ldevillez/customKeyboard/README.md

# customKeyboard

Improve tipping skills
