ldevillez/customKeyboard/custom_V1/readme.md

# V1
The V1 is based on the ergodox but with sone nice features
* USB C
* USB hub (2.0)
* Each half are independent
##

## subversions
* The "logic" version of the pcb is just the upper-part of it with all the logic(teensy, hub,leds) to have a smaller pcb. It would have been great to have it reduce under 10 mm. The all version is also there for the switch.

## Shopping list
<table>
  <thead>
    <tr>
    <th>Amount</th>
    <th>Part type</th>
    <th>Description</th>
    <th>Price (to pay)</th>
    <th>Link</th>
    </tr>
  </thead>
  <tbody>
    <tr>
      <th>2</th>
      <th>Teensy LC</th>
      <th> </th>
      <th>28.44</th>
      <th>https://www.digikey.be/product-detail/fr/sparkfun-electronics/DEV-13305/1568-1233-ND/5721428</th>
    </tr>
    <tr>
      <th>4</th>
      <th>Header 14*1 2.54mm</th>
      <th>For teensy</th>
      <th>2.4</th>
      <th>https://www.digikey.be/product-detail/en/w%C3%BCrth-elektronik/61301411121/732-5325-ND/4846849</th>
    </tr>
    <tr>
      <th>10</th>
      <th>Led jaune SMD</th>
      <th>For usb hub</th>
      <th>2.33</th>
      <th>https://www.digikey.be/product-detail/fr/qt-brightek-qtb/QBLP615-Y/1516-1077-1-ND/4814804</th>
    </tr>
    <tr>
      <th>16</th>
      <th>R smd 150</th>
      <th>R smd led</th>
      <th>3.6</th>
      <th>https://www.digikey.be/product-detail/fr/rohm-semiconductor/LTR18EZPF1500/RHM150YCT-ND/4055449</th>
    </tr>
    <tr>
      <th>8</th>
      <th>R smd 4.99k</th>
      <th>For usb type C </th>
      <th>2.36</th>
      <th>https://www.digikey.be/product-detail/fr/vishay-dale/RCL06124K99FKEA/541-2378-1-ND/2587746</th>
    </tr>
    <tr>
      <th>2</th>
      <th>R smd 2.7k</th>
      <th>Usb hub</th>
      <th>0.26</th>
      <th>https://www.digikey.be/product-detail/fr/rohm-semiconductor/LTR18EZPF2701/RHM2-70KYCT-ND/1973120</th>
    </tr>
    <tr>
      <th>2</th>
      <th>Connector USB A</th>
      <th></th>
      <th>0.78</th>
      <th>https://www.digikey.be/product-detail/fr/on-shore-technology-inc/USB-A1HSW6/ED2989-ND/2677750</th>
    </tr>
    <tr>
      <th>4</th>
      <th>Connector USB C</th>
      <th></th>
      <th>2.52</th>
      <th>https://www.digikey.be/product-detail/fr/cvilux-usa/CU3216SASBLR004-NH/2987-CU3216SASBLR004-NHCT-ND/13177603</th>
    </tr>
    <tr>
      <th>6</th>
      <th>USBLC6</th>
      <th>Protect device when connecting usb</th>
      <th>2.01</th>
      <th>https://www.digikey.be/product-detail/fr/stmicroelectronics/USBLC6-2SC6/497-5235-1-ND/1121688</th>
    </tr>
    <tr>
      <th>10</th>
      <th>Led TH</th>
      <th>Only use 1 pin</th>
      <th>2.26</th>
      <th>https://www.digikey.be/product-detail/fr/lite-on-inc/LTL-1BEHJ/160-1938-ND/3198396</th>
    </tr>
    <tr>
      <th>4</th>
      <th>C 10u</th>
      <th></th>
      <th>0.92</th>
      <th>https://www.digikey.be/product-detail/fr/avx-corporation/12061C103KAZ2A/478-3577-1-ND/1024930</th>
    </tr>
    <tr>
      <th>2</th>
      <th>R 510</th>
      <th></th>
      <th>0.22</th>
      <th>https://www.digikey.be/product-detail/fr/rohm-semiconductor/LTR18EZPJ511/RHM510ZCT-ND/1973140</th>
    </tr>
    <tr>
      <th>2</th>
      <th>74LS14 N</th>
      <th>Porte logique</th>
      <th>0.98</th>
      <th>https://www.digikey.be/product-detail/fr/texas-instruments/SN74LS14DBR/296-26505-1-ND/2255024</th>
    </tr>
    <tr>
      <th>100</th>
      <th>Diodes SMD</th>
      <th></th>
      <th>3.99</th>
      <th>https://www.digikey.be/product-detail/fr/on-semiconductor/MMSD4148T1G/MMSD4148T1GOSCT-ND/1121611</th>
    </tr>
    <tr>
      <th>100</th>
      <th>Diodes </th>
      <th>Alt to smd ones</th>
      <th>2.06</th>
      <th>https://www.digikey.be/product-detail/fr/on-semiconductor/1N4148/1N4148FS-ND/458603</th>
    </tr>
    <tr>
      <th>88</th>
      <th>Cherry MX brown</th>
      <th></th>
      <th>30.92</th>
      <th>https://fr.aliexpress.com/item/1005001681627152.html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,searchweb201602_,searchweb201603_</th>
    </tr>
    <tr>
      <th>1</th>
      <th>Cable ubs C-C 3.0</th>
      <th>Need 3.0 not 2.0 </th>
      <th>9.10</th>
      <th>https://www.digikey.be/product-detail/fr/cui-devices/CBLT-UC-UC-1WT/102-5955-ND/9838607</th>
    </tr>
    <tr>
      <th>2</th>
      <th>IC Hub usb 2.0 </th>
      <th></th>
      <th>3</th>
      <th>https://fr.aliexpress.com/item/33046559993.html?spm=a2g0o.cart.0.0.79213c00v1W7BP&mp=1</th>
    </tr>
    <tr>
    <th>Total</th>
    <th></th>
    <th></th>
    <th> 90.69 </th>
    <th></th>
  </tbody>
</table>

### Switch
I don't really know which switch fit me the best so i prefer buy cheap one for the prototype and remplace them later with **real** cherry mx. For example https://www.digikey.com/en/products/detail/cherry-americas-llc/MX1A-E1NW/20180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
