ldevillez/customKeyboard/custom_V1/3DCase/Support_LEFT.SLDPRT

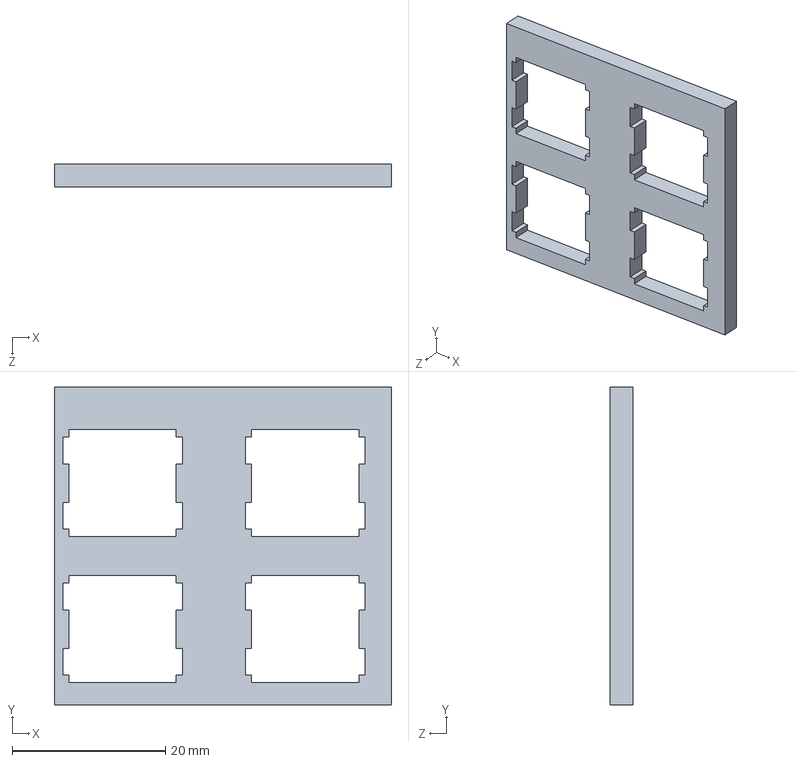
[picture p1: CAD file, 2021-07-03]
custom_V1/3DCase/Support_LEFT.SLDPRT
44.0 x 41.4 x 3.00 mm
