ldevillez/customKeyboard/custom_V1/pcb_all/custom-all.step

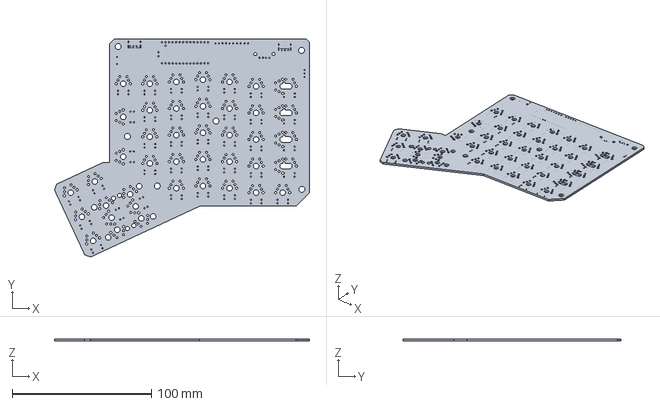
[picture p2: CAD file, 2021-01-19]
custom_V1/pcb_all/custom-all.step
182.8 x 156.3 x 1.60 mm
