ldevillez/customKeyboard/custom_V1/pcb_one_mcu/HDMR-19-02-S-SM/HDMR-19-02-S-SM.step

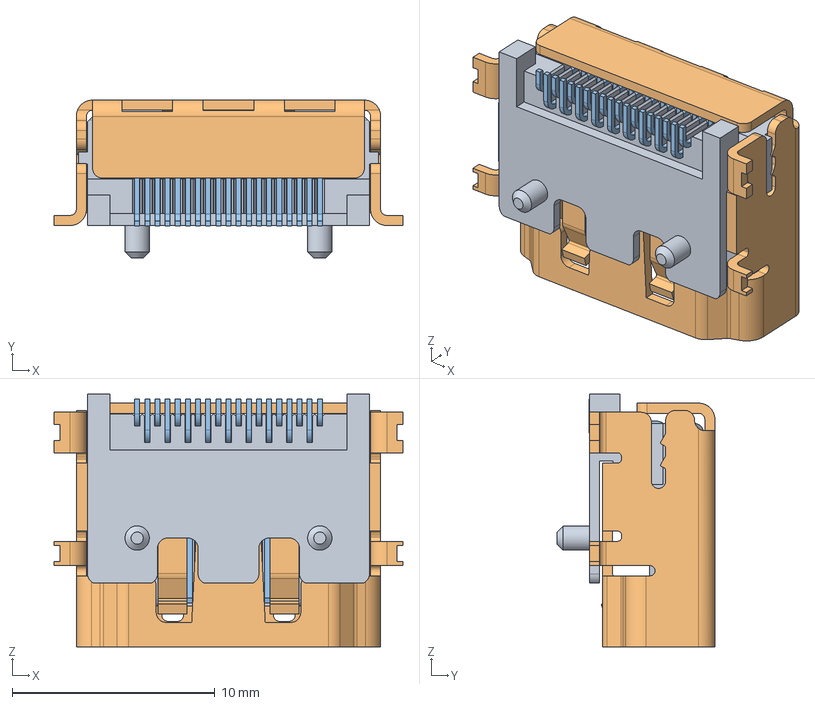
[picture p3: CAD file, 2021-11-21]
custom_V1/pcb_one_mcu/HDMR-19-02-S-SM/HDMR-19-02-S-SM.step
17.2 x 7.78 x 12.4 mm
_HDMR-19-02-S-SM_b
_HDMR-19-02-S-SM_s
_HDMR-19-02-S-SM_p
