ldevillez/customKeyboard/custom_V1/pcb_one_mcu/usbC/USB4085-GF-A_REVA.step

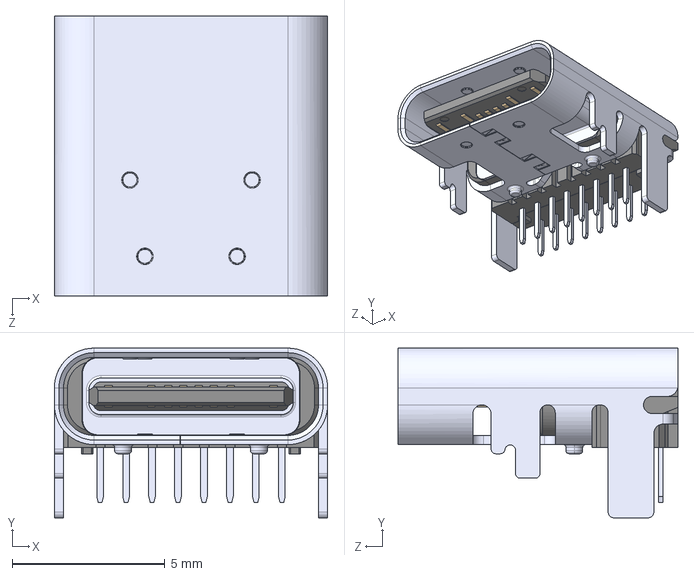
[picture p4: CAD file, 2021-01-13]
custom_V1/pcb_one_mcu/usbC/USB4085-GF-A_REVA.step
8.95 x 5.56 x 9.17 mm
