ldevillez/customKeyboard/custom_V1/3DCase/test_patte_1.SLDPRT

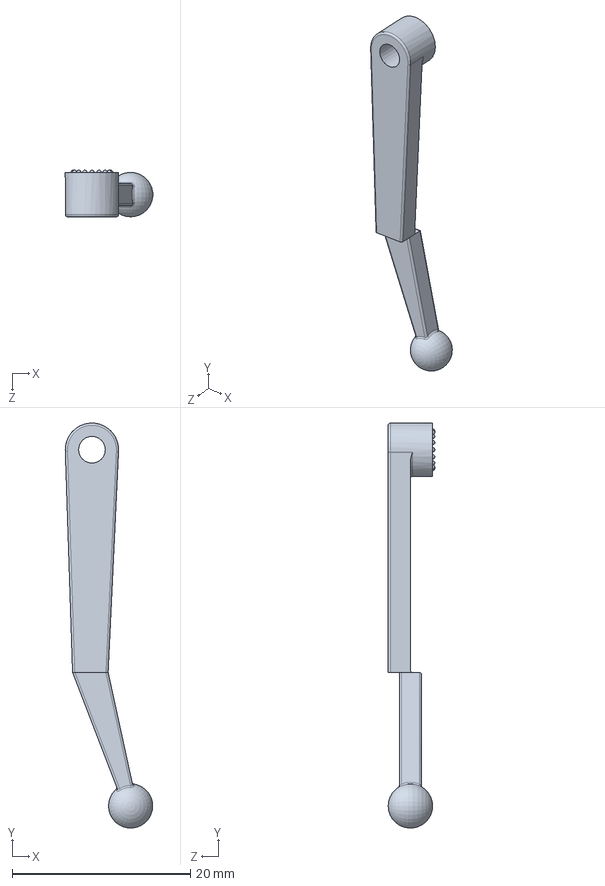
[picture p5: CAD file, 2021-03-21]
custom_V1/3DCase/test_patte_1.SLDPRT
9.83 x 45.5 x 5.25 mm
