ldevillez/customKeyboard/custom_V1/3DCase/Support_logic_all.STL

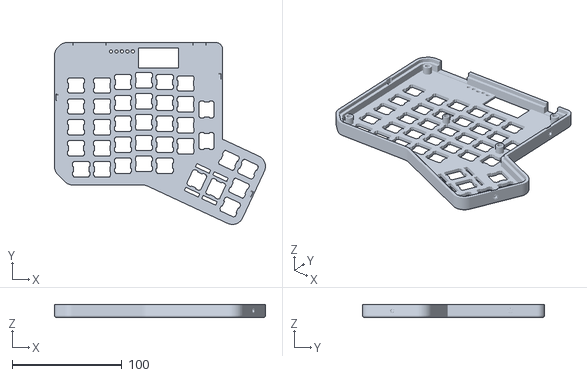
[picture p6: CAD file, 2021-03-21]
custom_V1/3DCase/Support_logic_all.STL
192.4 x 165.9 x 12.0
