ldevillez/customKeyboard/custom_V1/3DCase/Support.SLDPRT

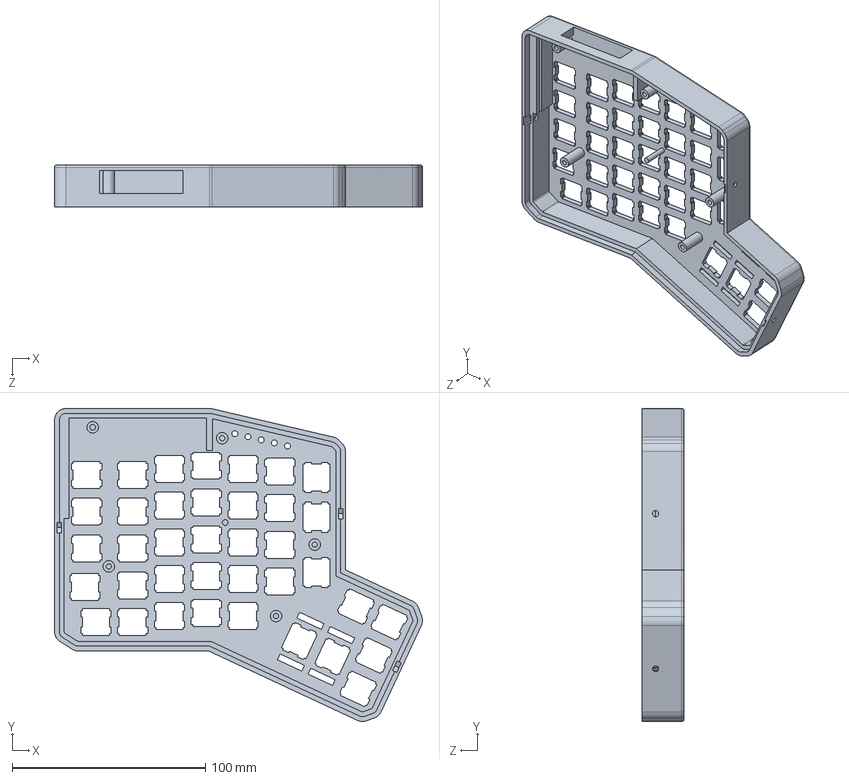
[picture p7: CAD file, 2021-03-21]
custom_V1/3DCase/Support.SLDPRT
190.6 x 162.2 x 22.0 mm
