ldevillez/customKeyboard/custom_V1/3DCase/Fond_logic.SLDPRT

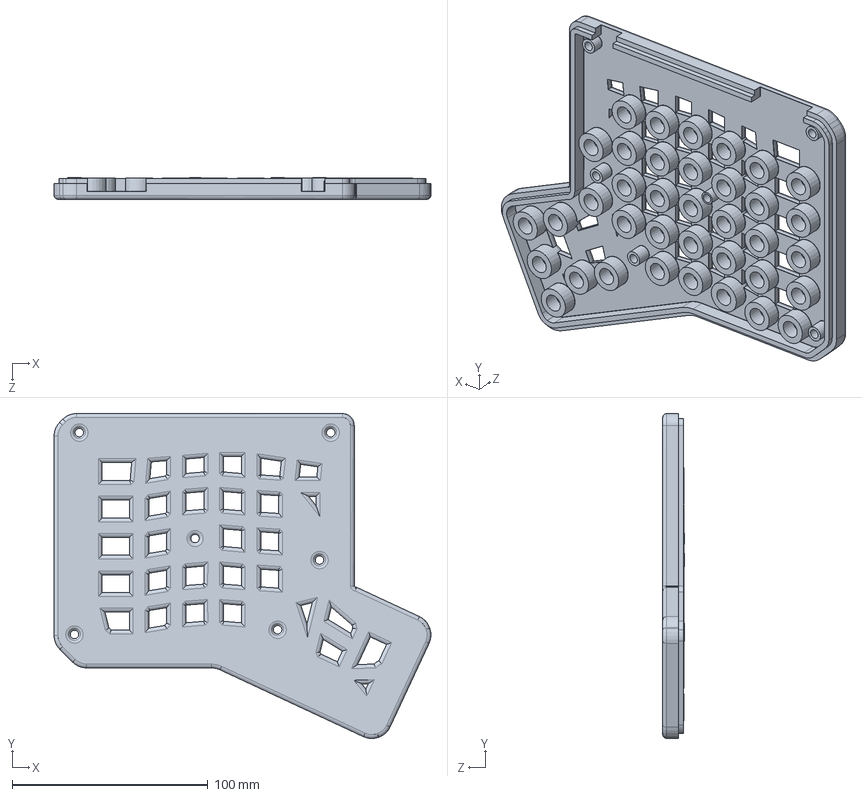
[picture p8: CAD file, 2021-03-21]
custom_V1/3DCase/Fond_logic.SLDPRT
192.4 x 165.9 x 11.0 mm
