ldevillez/customKeyboard/(list of files, cad)

Other CAD files:
custom_V1/3DCase/Test_full_SD.SLDPRT
custom_V1/3DCase/Support_logic.SLDPRT
custom_V1/3DCase/Support.STL
custom_V1/3DCase/Support_LEFT.STL
custom_V1/3DCase/Support_logic.STL
