ldevillez/customKeyboard/custom_V1/pcb_small/ErgoDOX_small.kicad_pcb

## KiCad design custom_V1/pcb_small/ErgoDOX_small.kicad_pcb (2021-11-21)

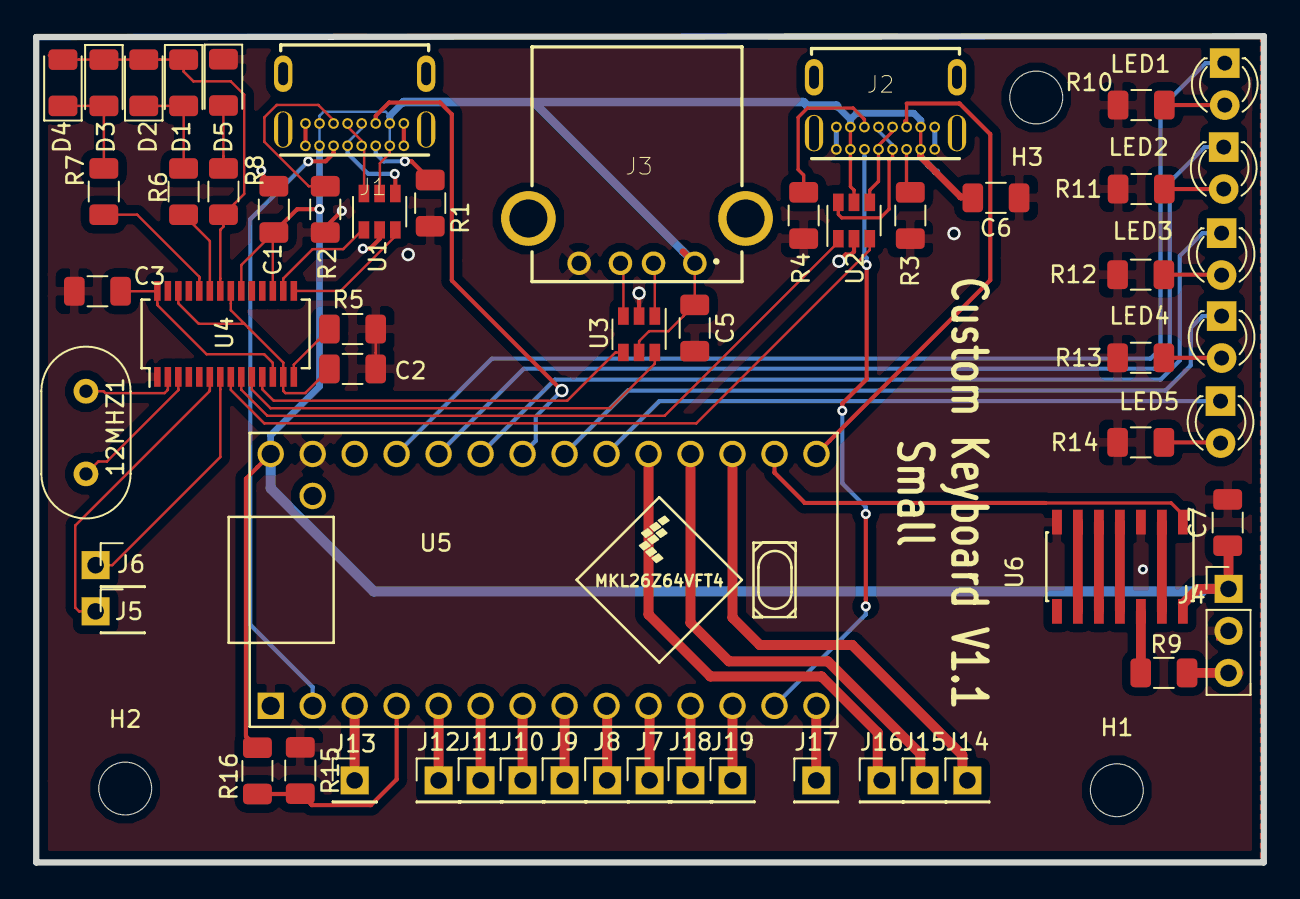
[picture p9: board ErgoDOX_small.kicad_pcb from above]

Board: 2 copper layers, 74.3 x 50.0 mm, 61 parts (0 on the bottom side), 66 nets.

Parts:
12MHZ1: Crystal; Resonator-2Pin_W10.0mm_H5.0mm
C1, C2, C3: 10u; C_1206_3216Metric
C5, C6, C7: 1u; C_1206_3216Metric
D1, D2, D3, D4, D5: D; LED_1206_3216Metric
H1: MountingHole; MountingHole_3.2mm_M3_DIN965
H2, H3: MountingHole; MountingHole_3.2mm_M3
J1: Input; GCT_USB4085-GF-A_REVA
J2: OutputC; GCT_USB4085-GF-A_REVA
J3: OutputA; 61400416021
J4: Conn_01x03; PinHeader_1x03_P2.54mm_Vertical
J5, J6, J7, J8, J9, J10, J11, J12, J13, J14, J15, J16, J17, J18, J19: Conn_01x01; PinHeader_1x01_P2.54mm_Vertical
LED1: LED1; LED_D3.0mm
LED2: LED2; LED_D3.0mm
LED3: LED3; LED_D3.0mm
LED4: LED4; LED_D3.0mm
LED5: LED5; LED_D3.0mm
R1, R2, R3, R4: 5.1k; R_1206_3216Metric
R5: 2.7k; R_1206_3216Metric
R6, R7, R8, R10, R11, R12, R13, R14: 150; R_1206_3216Metric
R9: 510; R_1206_3216Metric
R15, R16: 10k; R_1206_3216Metric
U1, U2, U3: USBLC6-2SC6; SOT-23-6
U4: FE1.1s; SSOP-28_3.9x9.9mm_P0.635mm
U5: Teensy-LC; Teensy_LC_CUSTOM_EDIT
U6: 74LS14; SOIC-14_3.9x8.7mm_P1.27mm

Connections:
+5V: C1.1, C5.2, C6.2, C7.1, J1.A4, J1.A9, J1.B4, J1.B9, J2.A4, J2.A9, J2.B4, J2.B9, J3.1, J4.1, R16.1, U1.5, U2.5, U3.5, U4.17, U4.20, U5.33, U6.14
/COL0: J7.1, U5.10
/COL1: J8.1, U5.9
/COL2: J9.1, U5.8
/COL3: J10.1, U5.7
/COL4: J11.1, U5.6
/COL5: J12.1, U5.5
/COL6: J13.1, U5.3
/ROW0: J14.1, U5.22
/ROW1: J15.1, U5.23
/ROW2: J16.1, U5.24
/ROW3: J17.1, U5.14
/ROW4: J19.1, U5.12
/ROW5: J18.1, U5.11
GND: C1.2, C2.2, C3.2, C5.1, C6.1, C7.2, D5.1, J1.A1, J1.A12, J1.B1, J1.B12, J2.A1, J2.A12, J2.B1, J2.B12, J3.4, J4.2, R1.2, R2.2, R3.2, R4.2, R5.2, R10.2, R11.2, R12.2, R13.2, R14.2, R15.1, U1.2, U2.2, U3.2, U4.1, U5.1, U5.32, U6.3, U6.7
INPUT_USB_CONN_D+: J1.A6, J1.B6, U1.6
INPUT_USB_CONN_D-: J1.A7, J1.B7, U1.4
INPUT_USB_D+: U1.1, U4.16
INPUT_USB_D-: U1.3, U4.15
L1: LED1.1, U5.30
L2: LED2.1, U5.29
L3: LED3.1, U5.28
L4: LED4.1, U5.26
L5: LED5.1, U5.25
LED_BACKLIGHT_33V: U5.21, U6.1
MOSI_IN: J1.A8, U5.2
MOSI_OUT: J2.A8, U5.13
unnamed: 12MHZ1.1, U4.3
unnamed: 12MHZ1.2, U4.2
unnamed: D1.1, D2.2, D3.1, D4.2, R8.2, U4.22
unnamed: D1.2, D2.1, R6.1
unnamed: D3.2, D4.1, R7.1
unnamed: D5.2, R8.1
unnamed: J1.A5, R1.1
unnamed: J1.B5, R2.1
unnamed: J1.P1, J1.P2, J1.P3, J1.P4
unnamed: J2.A5, R3.1
unnamed: J2.B5, R4.1
unnamed: J2.P1, J2.P2, J2.P3, J2.P4
unnamed: J4.3, R9.1
unnamed: LED1.2, R10.1
unnamed: LED2.2, R11.1
unnamed: LED3.2, R12.1
unnamed: LED4.2, R13.1
unnamed: LED5.2, R14.1
unnamed: R5.1, U4.14
unnamed: R6.2, U4.23
unnamed: R7.2, U4.24
unnamed: R9.2, U6.12
unnamed: R15.2, R16.2, U5.4
unnamed: U6.6, U6.9
unnamed: U6.5, U6.10
unnamed: U6.4, U6.11
unnamed: U6.2, U6.13
OUTPUTA_USB_CONN_D+: J3.3, U3.3
OUTPUTA_USB_D+: U3.4, U4.11
OUTPUTC_USB_CONN_D+: J2.A6, J2.B6, U2.6
OUTPUTC_USB_CONN_D-: J2.A7, J2.B7, U2.4
OUTPUTC_USB_D+: U2.1, U4.9
OUTPUTC_USB_D-: U2.3, U4.8
SCK_IN: J1.B8, U5.27
SCK_OUT: J2.B8, U5.20
TEENSY_USB_D+: J6.1, U4.7
TEENSY_USB_D-: J5.1, U4.6
VD18: C3.1, U4.12, U4.28
VD33: C2.1, U4.13, U4.21, U4.26
