ldevillez/customKeyboard/custom_V1/pcb_one_mcu/ergodox.kicad_pcb

## KiCad design custom_V1/pcb_one_mcu/ergodox.kicad_pcb (2021-11-21)

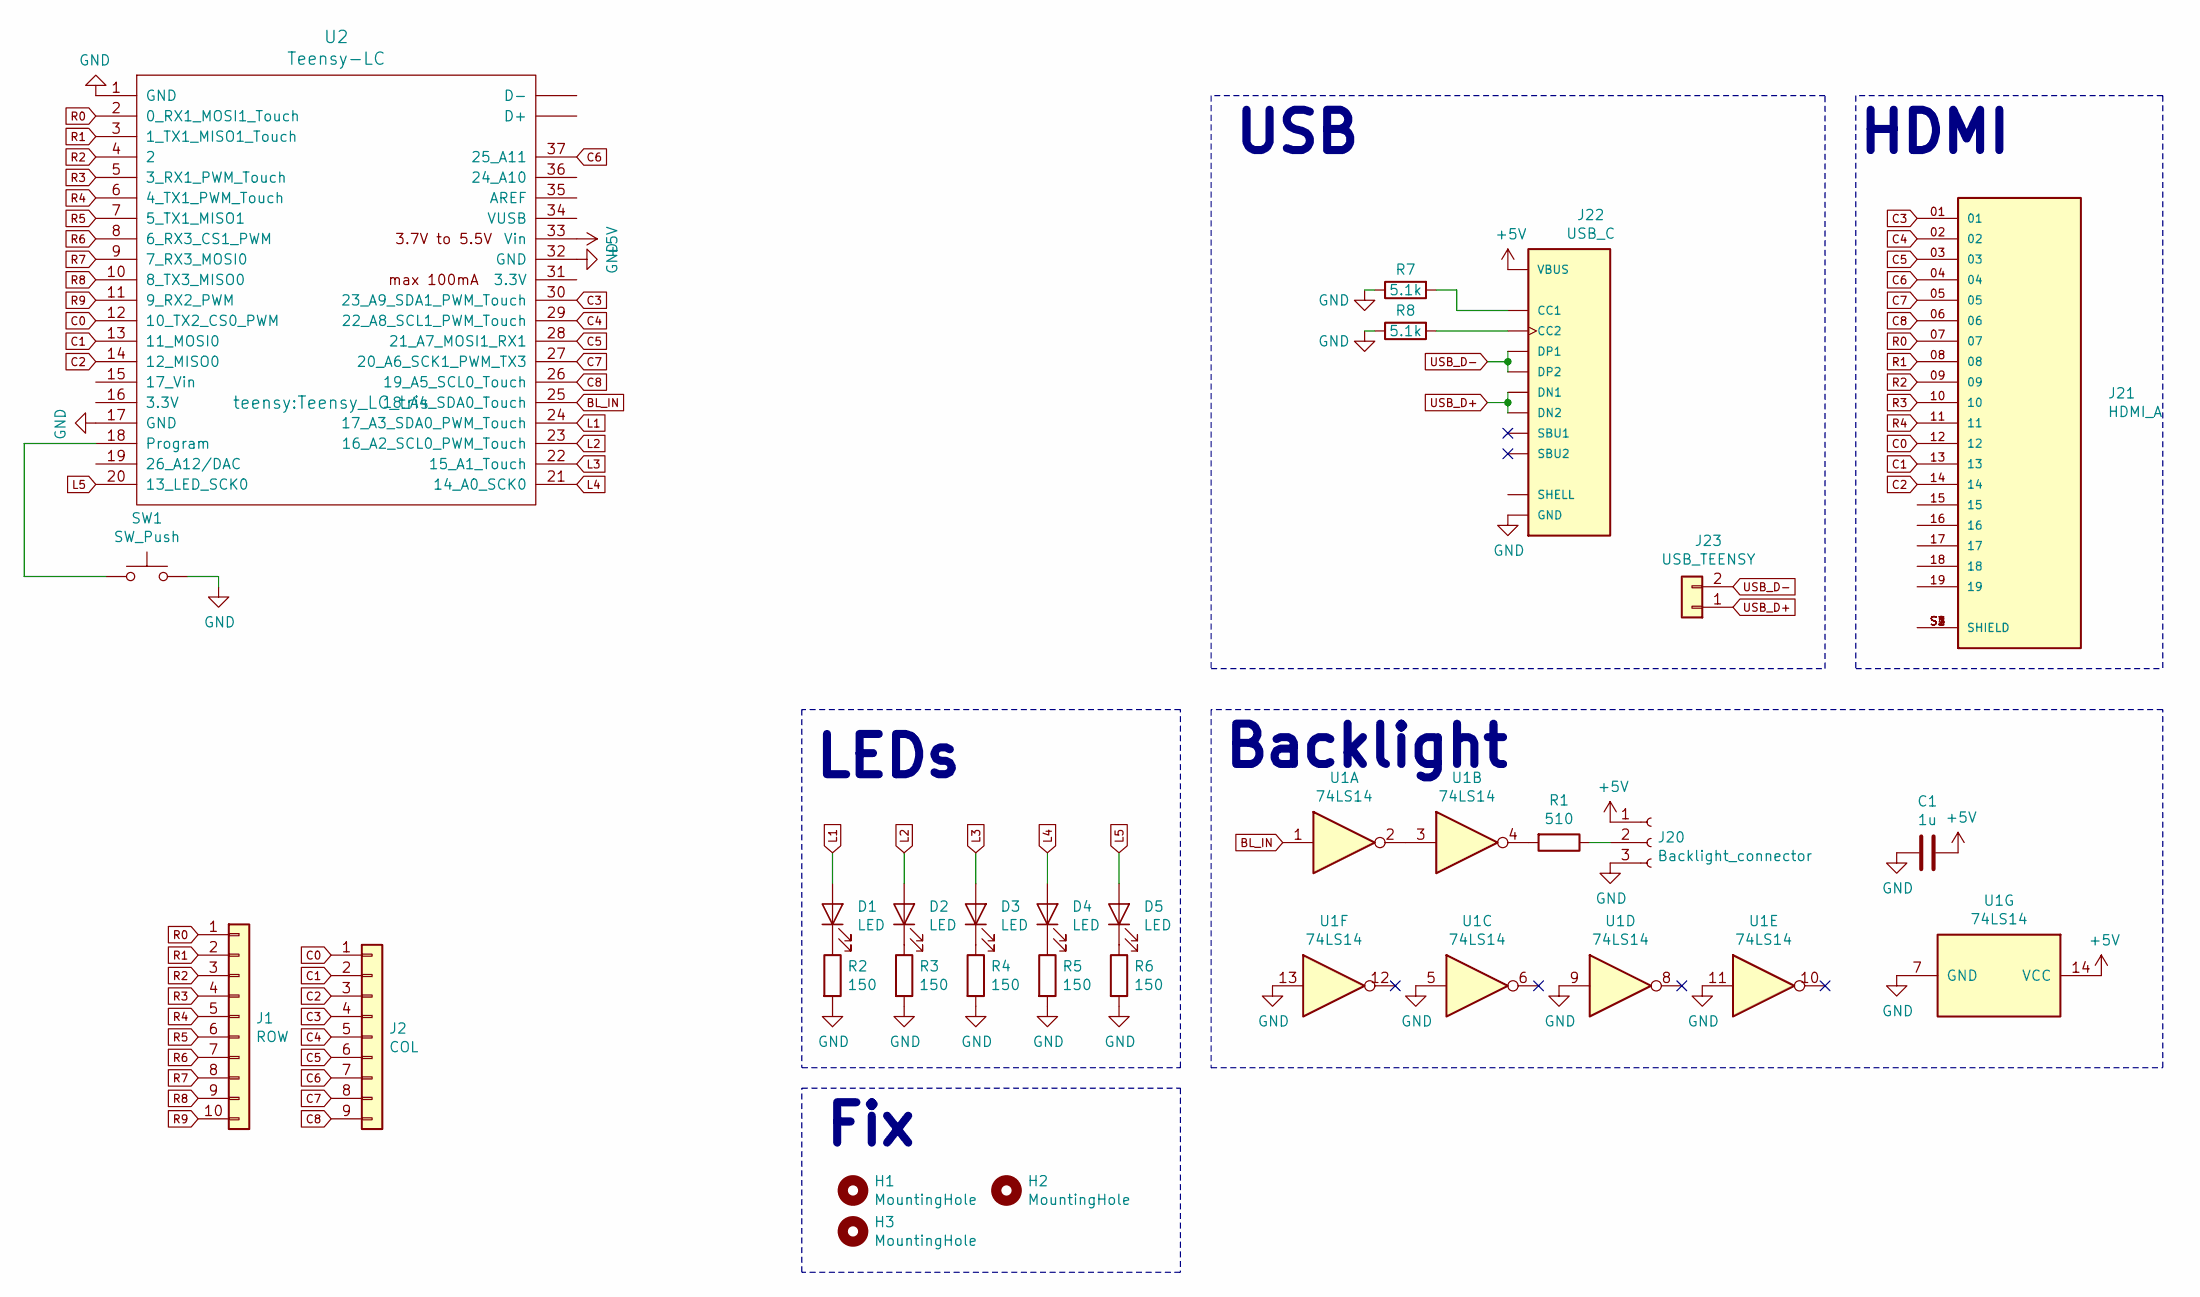
[picture p10: schematic ergodox.sch]

Parts:
C1: 1u; C_1206_3216Metric
D1, D2, D3, D4, D5: LED; LED_D3.0mm
H1, H2, H3: MountingHole; MountingHole_2.5mm
J1: ROW; PinHeader_1x10_P2.54mm_Vertical
J2: COL; PinHeader_1x09_P2.54mm_Vertical
J20: Backlight_connector; PinHeader_1x03_P2.54mm_Vertical
J21: HDMI_A; SAMTEC_HDMR-19-02-S-SM
J22: USB_C; GCT_USB4085-GF-A_REVA
J23: USB_TEENSY; PinHeader_1x02_P2.54mm_Vertical
R1: 510; R_1206_3216Metric
R2, R3, R4, R5, R6: 150; R_1206_3216Metric
R7, R8: 5.1k; R_1206_3216Metric
SW1: SW_Push; SW_Tactile_SPST_Angled_PTS645Vx39-2LFS
U1: 74LS14; SOIC-14_3.9x8.7mm_P1.27mm
U2: Teensy-LC; Teensy_LC_tris

Connections:
+5V: C1.1, J20.1, J22.A4 (VBUS), J22.A9 (VBUS), J22.B4 (VBUS), J22.B9 (VBUS), U1.14 (VCC), U2.33 (Vin)
BL_IN: U1.1, U2.25 (18_A4_SDA0_Touch)
C0: J2.1, J21.12, U2.12 (10_TX2_CS0_PWM)
C1: J2.2, J21.13, U2.13 (11_MOSI0)
C2: J2.3, J21.14, U2.14 (12_MISO0)
C3: J2.4, J21.01, U2.30 (23_A9_SDA1_PWM_Touch)
C4: J2.5, J21.02, U2.29 (22_A8_SCL1_PWM_Touch)
C5: J2.6, J21.03, U2.28 (21_A7_MOSI1_RX1)
C6: J2.7, J21.04, U2.37 (25_A11)
C7: J2.8, J21.05, U2.27 (20_A6_SCK1_PWM_TX3)
C8: J2.9, J21.06, U2.26 (19_A5_SCL0_Touch)
GND: C1.2, J20.3, J22.A1 (GND), J22.A12 (GND), J22.B1 (GND), J22.B12 (GND), R2.2, R3.2, R4.2, R5.2, R6.2, R7.1, R8.1, SW1.2, U1.5, U1.7 (GND), U1.9, U1.11, U1.13, U2.1 (GND), U2.17 (GND), U2.32 (GND)
L1: D1.2 (A), U2.24 (17_A3_SDA0_PWM_Touch)
L2: D2.2 (A), U2.23 (16_A2_SCL0_PWM_Touch)
L3: D3.2 (A), U2.22 (15_A1_Touch)
L4: D4.2 (A), U2.21 (14_A0_SCK0)
L5: D5.2 (A), U2.20 (13_LED_SCK0)
unnamed: D1.1 (K), R2.1
unnamed: D2.1 (K), R3.1
unnamed: D3.1 (K), R4.1
unnamed: D4.1 (K), R5.1
unnamed: D5.1 (K), R6.1
unnamed: J20.2, R1.1
unnamed: J21.S1 (SHIELD), J21.S2 (SHIELD), J21.S3 (SHIELD), J21.S4 (SHIELD)
unnamed: J22.A5 (CC1), R7.2
unnamed: J22.B5 (CC2), R8.2
unnamed: J22.P1 (SHELL), J22.P2 (SHELL), J22.P3 (SHELL), J22.P4 (SHELL)
unnamed: R1.2, U1.4
unnamed: SW1.1, U2.18 (Program)
unnamed: U1.2, U1.3
R0: J1.1, J21.07, U2.2 (0_RX1_MOSI1_Touch)
R1: J1.2, J21.08, U2.3 (1_TX1_MISO1_Touch)
R2: J1.3, J21.09, U2.4 (2)
R3: J1.4, J21.10, U2.5 (3_RX1_PWM_Touch)
R4: J1.5, J21.11, U2.6 (4_TX1_PWM_Touch)
R5: J1.6, U2.7 (5_TX1_MISO1)
R6: J1.7, U2.8 (6_RX3_CS1_PWM)
R7: J1.8, U2.9 (7_RX3_MOSI0)
R8: J1.9, U2.10 (8_TX3_MISO0)
R9: J1.10, U2.11 (9_RX2_PWM)
USB_D+: J22.A7 (DN1), J22.B7 (DN2), J23.1
USB_D-: J22.A6 (DP1), J22.B6 (DP2), J23.2

Notes on the sheet:
Backlight
LEDs
Fix
HDMI
USB

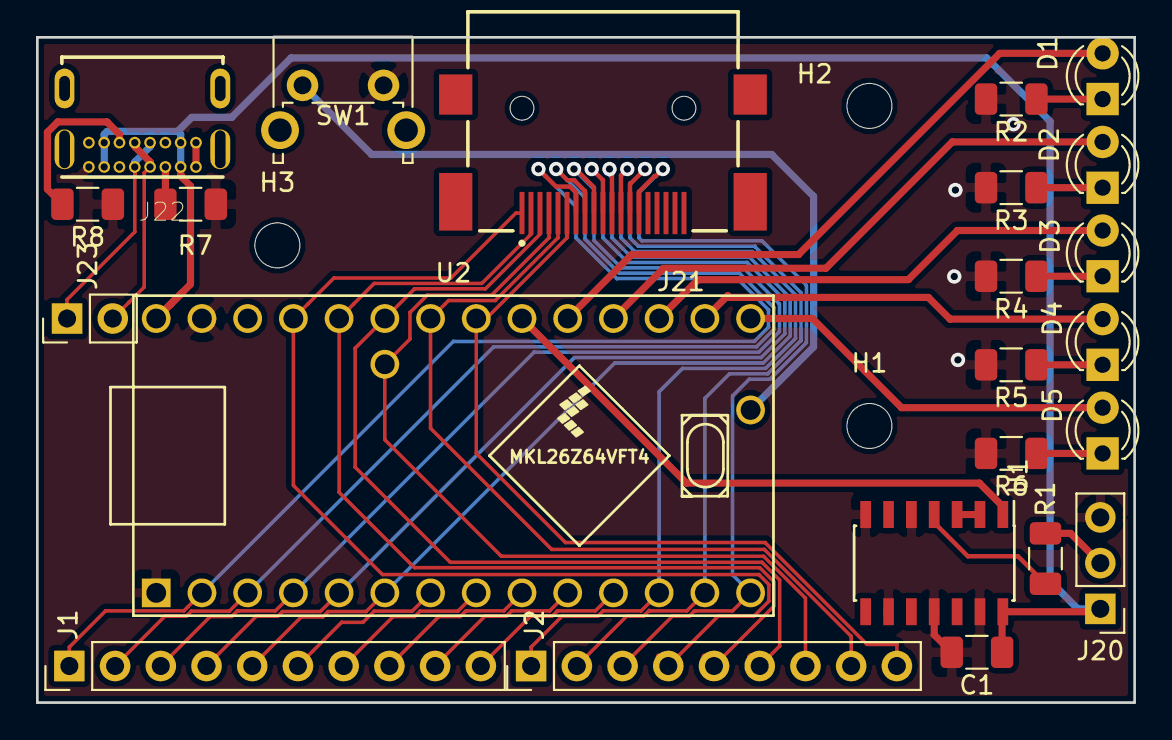
[picture p11: board ergodox.kicad_pcb from above]

Board: 2 copper layers, 61.0 x 37.0 mm, 26 parts (0 on the bottom side), 42 nets.
