ldevillez/customKeyboard/(commit log)

2021-01-13 first version
    [ErgoDOX-2020-12-30-20-05-08.sch, ErgoDOX-2020-12-30-20-10-49.sch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]
2021-01-13 add logic version for V1
    [ErgoDOX-2020-12-30-20-05-08.sch, ErgoDOX-2020-12-30-20-10-49.sch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]
2021-01-19 add step of custom
    [ErgoDOX.kicad_pcb, ErgoDOX.sch, custom-all.step, custom-logic.step]
2021-02-27 add V1.1 pcb
    [ErgoDOX-2020-12-30-20-05-08.sch, ErgoDOX-2020-12-30-20-10-49.sch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]
2021-03-21 big updates
    [ErgoDOX-2020-12-30-20-05-08.sch, ErgoDOX-2020-12-30-20-10-49.sch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]
2021-05-21 fix flawn in design
    [Support_LEFT.SLDPRT, Support_LEFT.STL]
2021-11-21 add 1 mcu
    [ErgoDOX_small.kicad_pcb, ErgoDOX_small.sch, HDMR-19-02-S-SM.step, USB4085-GF-A_REVA.step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]
