ldevillez/customKeyboard/(notices)

Notices in the files:
custom_V1/pcb_one_mcu/HDMR-19-02-S-SM/HDMR-19-02-S-SM.step:
FILE_NAME( 'e:/temp/worker_62/temp/exporttempdir_1144_138_z3J61/format_0/HDMR-19-02-S-SM.stp', '2021-08-15T16:51:09', ( 'License CC BY-ND 4.0' ), ( 'CADENAS' ), ' ', 'PARTsolutions', ' ' );
